peterkappelt/kHome/README.md

Devices for smart- and connected home.

Planned is (and there will surely be more in the future):
* a temperature sensor
* a thermostat
* a window contact
