peterkappelt/kHome/software/simple-quickfix/sensor_tempSensHW1_tirtos_ccs/README.md

## Example Summary

Sample application to control on-board LEDs with the PWM driver.

## Peripherals Exercised

* `Board_PWM0` - PWM instance used to control `Board_GPIO_LED0` brightness
* `Board_PWM1` - PWM instance used to control `Board_GPIO_LED1` brightness

## Resources & Jumper Settings

> If you're using an IDE (such as CCS or IAR), please refer to Board.html in your project
directory for resources used and board-specific jumper settings. Otherwise, you can find
Board.html in the directory &lt;SDK_INSTALL_DIR&gt;/source/ti/boards/&lt;BOARD&gt;.

## Example Usage

* Run the example.

* The onboard LEDs will slowly vary in intensity.

* If `Board_PWM0` and `Board_PWM1` are different (connected to two LEDs),
both LEDs will fade-in and fade-out when running the application.  Otherwise,
only one LED will fade-in and fade-out.

## Application Design Details

This application uses one thread, `mainThread` , which performs the following actions:

1. Opens and initializes PWM driver objects.

2. Uses the PWM driver to change the intensity of the LEDs.

3. The thread sleeps for 50 milliseconds before changing LED intensity again.

TI-RTOS:

* When building in Code Composer Studio, the kernel configuration project will be imported along with the example. The kernel configuration project is referenced by the example, so it will be built first. The "release" kernel configuration is the default project used. It has many debug features disabled. These feature include assert checking, logging and runtime stack checks. For a detailed difference between the "release" and "debug" kernel configurations and how to switch between them, please refer to the SimpleLink MCU SDK User's Guide. The "release" and "debug" kernel configuration projects can be found under &lt;SDK_INSTALL_DIR&gt;/kernel/tirtos/builds/&lt;BOARD&gt;/(release|debug)/(ccs|gcc).

FreeRTOS:

* Please view the `FreeRTOSConfig.h` header file for example configuration
information.
