peterkappelt/kHome/hardware/devices/temperatureSensor/software/CC1310/README.md

# temperatureSensor Hardware V1 Software

The embedded software is stored centrally.
You can find it at /software/cc1310
