peterkappelt/kHome/software/desktop/kHome-devedit/src/net/kappelt/kHome/devedit/kappelt-small-invers-135px.png

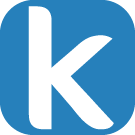
software/desktop/kHome-devedit/src/net/kappelt/kHome/devedit/kappelt-small-invers-135px.png
