peterkappelt/kHome/hardware/devices/temperatureSensor/temperatureSensor/Project Outputs for temperatureSensor/temperatureSensor_supplier.xls

Sheet: BOM Report
Bill of Materials |  |  | Bill of Materials For Variant [batch_one] of Project [temperatureSensor.PrjPcb] (No PCB Document Selected)
Source Data From: |  | temperatureSensor.PrjPcb
Project: |  | temperatureSensor.PrjPcb
Variant: |  | batch_one
Creation Date: | 18.03.2017 | 22:31:02
Print Date: | 2017-03-18 | 22:49:02
Production Quantity: | 5
Currency | <none>
Footprint | Comment | LibRef | Designator | Description | Quantity | Supplier 1 | Supplier Part Number 1 | Supplier Unit Price 1 | Supplier Order Qty 1 | Supplier Subtotal 1 | Manufacturer 1 | Manufacturer Part Number 1
Keystone-2468 | 2x AAA | Battery-AAA-Double | BT1 | Double AAA Battery Holder | 1 | Mouser | 534-2468 | 1,57 | 5 | 7,85 | Keystone Electronics | 2468
0603_N | 100n | 100n_50V_0603 | C1, C2, C4, C6, C8, C9, C10 | 100n 50V 0603 | 7 | Mouser | 710-885012206071 | 0,028 | 35 | 0,98 | Wurth Electronics | 885012206071
0805_N | 22u | 22u_25V_0805 | C3, C7 | 22u 25V 0805 | 2 | Mouser | 81-GRM21BC80G226ME9L | 0,09 | 10 | 0,9 | Murata Electronics | GRM21BC80G226ME39L
0603_N | 100p | 100p_50V_0603 | C11 | 100p 50V 0603 | 1 | Mouser | 710-885012206003 | 0,038 | 5 | 0,19 | Wurth Electronics | 885012206003
0603_N | 3.3p | 3p3_50V_0603 | C12, C21 | 3p3 50V 0603 | 2 | Mouser | 81-GRM1885C1H3R3CA1D | 0,026 | 10 | 0,26 | Murata Electronics | GRM1885C1H3R3CA01D
0805_N | 15p | 10p_50V_0805 | C15, C16 | 15p 50V 0805 | 2 | Mouser | 710-885012007001 | 0,066 | 10 | 0,66 | Wurth Electronics | 885012007001
0603_N | 1p | 100p_50V_0603 | C17 | 1p 50V 0603 | 1 | Mouser | 609-251R14S1R0CV4T | 0,085 | 5 | 0,425 | Johanson Dielectrics | 251R14S1R0CV4T
0603_N | 2.7p | 3p3_50V_0603 | C18 | 2p7 50V 0603 | 1 | Mouser | 81-GRM1885C1H2R7CA1D | 0,027 | 10 | 0,27 | Murata Electronics | GRM1885C1H2R7CA01D
0603_N | 6.2p | 3p3_50V_0603 | C19 | 6p2 50V 0603 | 1 | Mouser | 581-06032U6R2BAT2A | 0,094 | 5 | 0,47 | AVX | 06032U6R2BAT2A
0603_N | 3.0p | 3p3_50V_0603 | C20 | 3p 50V 0603 | 1 | Mouser | 581-06035U3R0B | 0,094 | 5 | 0,47 | AVX | 06035U3R0BAT2A
0603_N | 1u | 1u_50V_0603 | C22 | 1u 50V 0603 | 1 | Mouser | 710-885012106010 | 0,075 | 5 | 0,375 | Wurth Electronics | 885012106010
cortex-dbg | Cortex Debug | Cortex-DBG | CON1 | Cortex Debug | 1
Header_254_1x3_male | 1x3 | Header_1x03_male | CON2 | Male Connector 1x3 | 1
0805_LED | LED Red | LED-STD-RED-0805 | D1 | Standard LED Red 0805 | 1 | Mouser | 604-AP2012EC | 0,123 | 5 | 0,615 | Kingbright | AP2012EC
0603_N | Ferrite Bead | Inductor_General_Purpose_0603 | L1 | Ferrite Bead | 1 | Mouser | 81-BLM18HE152SN1D | 0,198 | 5 | 0,99 | Murata Electronics | BLM18HE152SN1D
0805_N | 6.8 µH | Inductor_General_Purpose_0603 | L2 | Chip Inductor 0805 | 1 | Mouser | 810-MLZ2012N6R8L | 0,123 | 5 | 0,615 | TDK | MLZ2012N6R8L
0603_N | 8.2nH | Inductor_General_Purpose_0603 | L3, L7 | 8.2nH Inductor | 2 | Mouser | 81-LQG15HS8N2J02D | 0,046 | 10 | 0,46 | Murata Electronics | LQG15HS8N2J02D
0603_N | 22nH | Inductor_General_Purpose_0603 | L4 | 22nH Inductor | 1 | Mouser | 81-LQG15HS22NJ02D | 0,046 | 10 | 0,46 | Murata Electronics | LQG15HS22NJ02D
0603_N | 6.8nH | Inductor_General_Purpose_0603 | L5, L6 | 6.8H Inductor | 2 | Mouser | 81-LQG15HS6N8J02D | 0,046 | 10 | 0,46 | Murata Electronics | LQG15HS6N8J02D
0603_N | 12nH | Inductor_General_Purpose_0603 | L8 | Inductor for PCB Antenna compensation | 1 | Mouser | 609-L-14C12NJV4T | 0,066 | 5 | 0,33 | Johanson Technology | L-14C12NJV4T
LFXTAL058124 | Quartz 20 MHz | LFXTAL058124 | Q2 | Standard 3.2 x 2.5mm SMD crystal in a ceramic package with a seam sealed metal lid, hermetically sealed. | 1 | Mouser | 449-LFXTAL058124REEL | 0,462 | 5 | 2,31 | IQD | LFXTAL058124Reel
0603_N | 0R | 0R_100mW_0603 | R2 | 0R 100mW 0603 | 1
0805_N | 10k | 10k_125mW_0805 | R5, R6 | 10k 125mW 0805 | 2 | Mouser | 588-AS08J1002ET | 0,045 | 10 | 0,45 | Ohmite | AS08J1002ET
0603_N | 100k | 100k_100mW_0603 | R7 | 100k 100mW 0603 | 1 | Mouser | 71-RCA0603100KJNEC | 0,085 | 5 | 0,425 | Vishay / Draloric | RCA0603100KJNEC
0603_N | 1k | 1k_100mW_0603 | R8 | 1k 100mW 0603 | 1 | Mouser | 71-CRCW0603-1.0K-E3 | 0,041 | 10 | 0,41 | Vishay | CRCW06031K00FKEA
FSMSM | Push Button | Switch-FSMSM | SW1 | Taster, Nicht beleuchtet, 24 V, 50 mA, 180 gf, Baureihe FSMSM, AlcoSwitch | 1 | Mouser | 506-FSMSM | 0,255 | 5 | $1275.00 | TE Connectivity / Alcoswitch | FSMSM
SI7020-DFN6 | Humidity & Temperature | SI7020 | U1 | I2C HUMIDITY AND TEMPERATURE SENSOR | 1 | Mouser | 634-SI7020-A20-GMR | 2,93 | 5 | 14,65 | Silicon Labs | SI7020-A20-GMR
CC1310F128RHB-QFN32 | CC1310 | CC1310F128RHB | U3 | CC1310 SimpleLink™ Ultra-Low-Power Sub-1 GHz Wireless MCU | 1 | Mouser | 595-CC1310F32RHBT | 5,65 | 5 | 28,25 | Texas Instruments | CC1310F32RHBT
 |  |  |  |  | 40 |  |  |  |  | $1275.00
Approved |  | Notes

Sheet: Project Information
Project Full Path | C:\Users\peter\Documents\Projekte\kHome\hardware\devices\temperatureSensor\temperatureSensor\temperatureSensor.PrjPcb
Project Filename | temperatureSensor.PrjPcb
Variant Name | batch_one
Data-Source Filename | temperatureSensor.PrjPcb
Data-Source Full Path | C:\Users\peter\Documents\Projekte\kHome\hardware\devices\temperatureSensor\temperatureSensor\temperatureSensor.PrjPcb
Title | Bill of Materials For Variant [batch_one] of Project [temperatureSensor.PrjPcb] (No PCB Document Selected)
Total Quantity | 40
Report Time | 22:31:02
Report Date | 18.03.2017
Report Date & Tine | 18.03.2017 22:31:02
Output Name | Bill of Materials
Output Type | BOM_PartType
Output Generator Name | BOM
Output Generator Description | Bill of Materials
