peterkappelt/kHome/doc/hardware/cc1310/cc1310emk/swrc315_design_files/assembly/CC13xxEM-5XD-7793_4L_partlist_1_0_0.xls

CC13xxEM-5XD-7793_4L Revised: Monday, October 19, 2015
Revision: 1.0.0
Bill Of Materials October 19,2015 20:55:34 | Page1
Part number | Quantity | Reference | Value | Description | Manufacturer | Manufacturer part number | PCB Package | Max operating temp | Note status | RoHS status
______________________________________________
13-00397 | 1 | A1 | Antenna PCB helix 868/915MHz | ANTENNA, NON COMPONENT, PCB HELIX 868/915MHz, NOT APPLY | TEXAS INSTRUMENTS | ANTENNA PCB HELIX 868/915MHz |  | N/A | PREFERRED | ROHS_COMPLIANT
02-02323 | 6 | C3,C4,C6,C9,C20,C23 | 100nF | CAPACITOR, CERAMIC X7R, 100nF, 6.3V, -10%/+10%, -55DEGC/+125DEGC, 0402, SMD | MURATA | GRM155R70J104KA01D | 402 | +125DEGC | PREFERRED | ROHS_COMPLIANT
02-07053 | 2 | C5,C8 | 22uF | CAPACITOR, CERAMIC, X5R, 22uF, 6.3V, -20%/+20%, -55DEGC/+85DEGC, 0603, SMD | MURATA | GRM188R60J226MEA0D | 603 | +85DEGC | PREFERRED | ROHS_COMPLIANT
02-04369 | 2 | C11,C22 | 3.3pF | CAPACITOR, CERAMIC C0G/NP0, 3.3pF, 50V, -0.25pF/+0.25pF, -55DEGC/+125DEGC, 0402, SMD | MURATA | GRM1555C1H3R3CA01D | 402 | +125DEGC | PREFERRED | ROHS_COMPLIANT
02-04679 | 1 | C12 | 2.7pF | CAPACITOR, CERAMIC C0G/NP0, 2.7pF, 50V, -0.25pF/+0.25pF, -55DEGC/+125DEGC, 0402, SMD | MURATA | GRM1555C1H2R7CA01D | 402 | +125DEGC | PREFERRED | ROHS_COMPLIANT
02-04608 | 1 | C13 | 6.2pF | CAPACITOR, CERAMIC C0G/NP0, 6.2pF, 50V, -0.25pF/+0.25pF, -55DEGC/+125DEGC, 0402, SMD | MURATA | GRM1555C1H6R2CA01D | 402 | +125DEGC | PREFERRED | ROHS_COMPLIANT
02-04606 | 1 | C14 | 3pF | CAPACITOR, CERAMIC C0G/NP0, 3pF, 50V, -0.25pF/+0.25pF, -55DEGC/+125DEGC, 0402, SMD | MURATA | GRM1555C1H3R0CA01D | 402 | +125DEGC | PREFERRED | ROHS_COMPLIANT
02-04365 | 2 | C15,C21 | 100pF | CAPACITOR, CERAMIC C0G/NP0, 100pF, 50V, -5%/+5%, -55DEGC/+125DEGC, 0402, SMD | MURATA | GRM1555C1H101JA01D | 402 | +125DEGC | PREFERRED | ROHS_COMPLIANT
02-04164 | 1 | C16 | DNM_0402 | CAPACITOR, CERAMIC, N/A VALUE, -55DEGC/+125DEGC, 0402, SMD | MANUFACTURER SELECTION | CAPACITOR_0402_DNM_N/A_M | 402 | +125DEGC | PREFERRED | MISSING_INFO
02-03030 | 2 | C17,C18 | 12pF | CAPACITOR, CERAMIC C0G/NP0, 12pF, 50V, -5%/+5%, -55DEGC/+125DEGC, 0402, SMD | MANUFACTURER SELECTION | CAPACITOR_0402_12pF_C0G/NP0_M_+/-5%_50V | 402 | +125DEGC | PREFERRED | ROHS_COMPLIANT
02-02381 | 1 | C19 | 1uF | CAPACITOR, CERAMIC X5R, 1uF, 10V, -10%/+10%, -55DEGC/+85DEGC, 0402, SMD | MURATA | GRM155R61A105KE15D | 402 | +85DEGC | PREFERRED | ROHS_COMPLIANT
02-04164 | 2 | C24,C25 | DNM | CAPACITOR, CERAMIC, N/A VALUE, -55DEGC/+125DEGC, 0402, SMD | Manufacturer selection | CAPACITOR_0402_DNM_N/A_M | 402 | +125DEGC | PREFERRED | PART NOT KNOWN
19-00111 | 6 | FIDU1,FIDU2,FIDU3,FIDU4,FIDU5,FIDU6 | FIDU_1MM | FIDUCIAL MARK, ROUND 1MM
04-00470 | 1 | FL1 | BLM18HE152SN1 | FILTER, EMI, 1500@100MHz, -55DEGC/+125DEGC, 0603, SMD | MURATA | BLM18HE152SN1D | 603 | +125DEGC | PREFERRED | ROHS_COMPLIANT
06-02188 | 1 | J1 | SMA-10V21-TGG | CONNECTOR, COAX RF, STRAIGHT, FEMALE, 1 PIN, SMD | HUS-TSAN | SMA-10V21-TGG |  |  | PREFERRED | N/A
03-07266 | 1 | L1 | 6.8uH | INDUCTOR, CHIP, FERRITE CORE, 6.8uH, -20%/+20%, IR:1.1A, -55DEGC/+125DEGC, 0805, SMD | TDK | MLZ2012N6R8LT000 | 805 | +125DEGC | PREFERRED | ROHS_COMPLIANT
03-06537 | 1 | L11 | 22nH | INDUCTOR, RF, CHIP, NON-MAGNETIC CORE, 22nH, -5%/+5%, 0.3A, -55DEGC/+125DEGC, 0402, SMD | MURATA | LQG15HS22NJ02D | 402 | +125DEGC | PREFERRED | ROHS_COMPLIANT
03-06634 | 2 | L12,L21 | 8.2nH | INDUCTOR, RF, CHIP, NON-MAGNETIC CORE, 8.2nH, -5%/+5%, 0.3A, -55DEGC/+125DEGC, 0402, SMD | MURATA | LQG15HS8N2J02D | 402 | +125DEGC | PREFERRED | ROHS_COMPLIANT
03-06633 | 2 | L13,L14 | 6.8nH | INDUCTOR, CHIP, 6.8nH, -5%/+5%, 0.3A, -55DEGC/+125DEGC, 0402, SMD | MURATA | LQG15HS6N8J02D | 402 | +125DEGC | PREFERRED | ROHS_COMPLIANT
03-01022 | 1 | L15 | TBD | INDUCTOR, TO BE DECIDED, 0402, SMD | MANUFACTURER SELECTION | IND_TBD_0402 |  |  | PREFERRED | ROHS_COMPLIANT
06-02251 | 2 | P1,P2 | SFM-110-02-S-D-A-K-TR | CONNECTOR, HEADER, FEMALE, STRAIGHT, 2 ROWS, 20 PINS, PITCH 1.27mm, SMD | SAMTEC | SFM-110-02-SM-D-A-K-TR |  | +125DEGC | PREFERRED | ROHS_COMPLIANT
01-12837 | 1 | R1 | 100k | RESISTOR, THICK FILM, 100k, -1%/+1%, 0.063W, 50V, -55DEGC/+155DEGC, 0402, SMD | MANUFACTURER SELECTION | RESISTOR_0402_100k_+/-1%_50V_0.063W_M_+/-100PPM | 402 | +155DEGC | PREFERRED | ROHS_COMPLIANT
01-11587 | 3 | R2,R5,R6 | 0 | RESISTOR, THICK FILM, 0, -5%/+5%, 0.063W, 50V, -55DEGC/+155DEGC, 0402, SMD | MANUFACTURER SELECTION | RESISTOR_0402_0_+/-5%_50V_0.063W_M_+/-200ppm | 402 | +155DEGC | PREFERRED | ROHS_COMPLIANT
01-02472 | 2 | R3,R4 | DNM | RESISTOR, DO NOT MOUNT, 0402, SMD | DO NOT MOUNT | DNM | 402 | N/A | PREFERRED | PART NOT KNOWN
18-28965 | 1 | U1 | CC13xx 5x5 | IC, ANALOG, CUSTOM, CC13xx 5x5, QFN32, SMD | TEXAS INSTRUMENTS | CC13XX 5X5 | QFN32 | N/A | PREFERRED | PART NOT KNOWN
12-00546 | 1 | Y1 | 32.768kHz | CRYSTAL, RESONATOR, 32.768kHz, -20PPM/+20PPM, -40DEGC/+85DEGC, SMD | EPSON | FC-135 32.7680KA-AG0 |  | +85DEGC | PREFERRED | ROHS_COMPLIANT
12-00419 | 1 | Y2 | 24MHz | CRYSTAL, OSCILATOR, 24MHz, -40DEGC/+85DEGC, SMD | EPSON | TSX-3225 24MHz |  | +85DEGC | PREFERRED | ROHS_COMPLIANT
