peterkappelt/kHome/(list of files, cad)

Other CAD files:
software/simple-quickfix/tirtos_builds_tempSens_HW1_release_ccs/src/sysbios/m3_IntrinsicsSupport_asm.obj
software/simple-quickfix/tirtos_builds_tempSens_HW1_release_ccs/src/sysbios/m3_TaskSupport_asm.obj
software/simple-quickfix/tirtos_builds_tempSens_HW1_release_ccs/src/sysbios/m3_Hwi_asm.obj
software/simple-quickfix/tirtos_builds_tempSens_HW1_release_ccs/src/sysbios/m3_Hwi_asm_switch.obj
software/simple-quickfix/tirtos_builds_tempSens_HW1_release_ccs/src/sysbios/rom_sysbios.obj
software/cc1310/tirtos_builds_tempSens_HW1_release_ccs/src/sysbios/m3_Hwi_asm_switch.obj
software/cc1310/tirtos_builds_CC1310_LAUNCHXL_release_ccs/src/sysbios/m3_Hwi_asm.obj
software/cc1310/tirtos_builds_tempSens_HW1_release_ccs/src/sysbios/m3_IntrinsicsSupport_asm.obj
software/cc1310/tirtos_builds_CC1310_LAUNCHXL_release_ccs/src/sysbios/m3_IntrinsicsSupport_asm.obj
software/cc1310/tirtos_builds_tempSens_HW1_release_ccs/src/sysbios/m3_Hwi_asm.obj
software/cc1310/tirtos_builds_CC1310_LAUNCHXL_release_ccs/src/sysbios/m3_TaskSupport_asm.obj
software/cc1310/tirtos_builds_tempSens_HW1_release_ccs/src/sysbios/m3_TaskSupport_asm.obj
software/cc1310/tirtos_builds_CC1310_LAUNCHXL_release_ccs/src/sysbios/m3_Hwi_asm_switch.obj
software/cc1310/tirtos_builds_CC1310_LAUNCHXL_release_ccs/src/sysbios/rom_sysbios.obj
software/cc1310/tirtos_builds_tempSens_HW1_release_ccs/src/sysbios/rom_sysbios.obj
