peterkappelt/kHome/software/cc1310/kHome-Gateway/kHome/test-device.html

# Device Report: test.khd

## Meta Information

- Author: Peter Kappelt
- Device ID: 0xAB
- Device Version: V1.0
- Device Comment: This is an empty device. Just for testing! An a second line of description.

## Data Registers

Address | Name | Length (Byte) | Initial Value | Read Only | Description
0x1 | dataRegOne | 2 | 15 | true | Read only, initial 15, dataRegOne, Length 2, Address 1
0x2 | dataRegTwo | 4 | 2 | false | initial 2, dataRegTwo, Length 4, Address 2

## Config Registers

Address | Name | Initial Value | Read Only | Description
0x5 | configOne | 2 | false | configOne, address 5, value 2
0x6 | configTwo | 7 | true | configTwo: address 6 value 7 read only

## Status Registers

Address | Name | Initial Value | Description
0x8 | statusOne | 3 | statusOne: Value 3 Address 8
0x9 | statusTwo | 200 | statusTwo: address 9 value 200
