peterkappelt/kHome/doc/hardware/cc1310/launchpad/design_files/LAUNCHXL-CC1310_1_3_0_Assy.pdf

## ART FILM - assembly_top

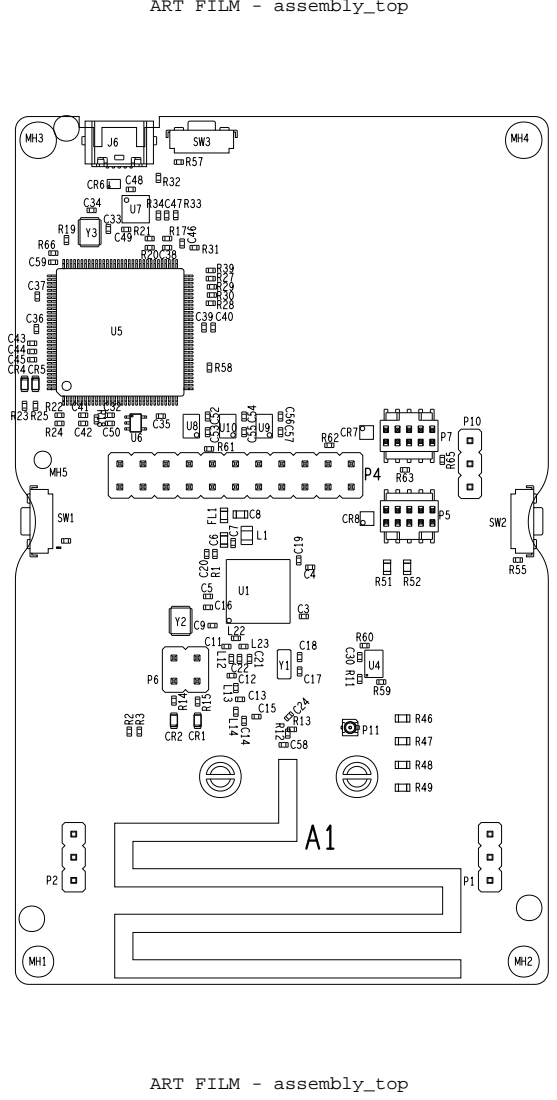
[picture p15: page 1]

## ART FILM - assembly_bottom_mirrored

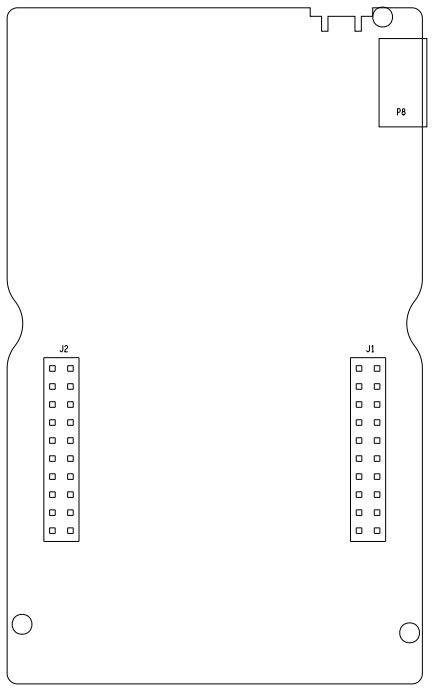
[picture p16: figure]

## ART FILM - assembly_bottom_mirrored
