peterkappelt/kHome/doc/hardware/cc1310/cc1310emk/swrc315_design_files/docs/CC13xxEM_5XD_7793_4L_assembly_1_0_0.pdf

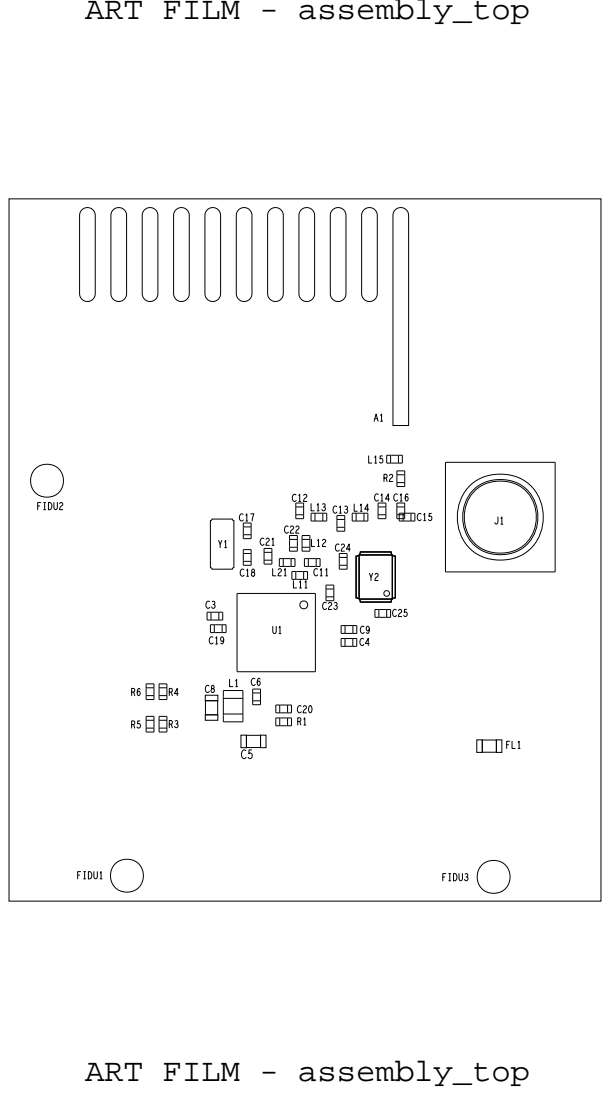
[picture p17: page 1]

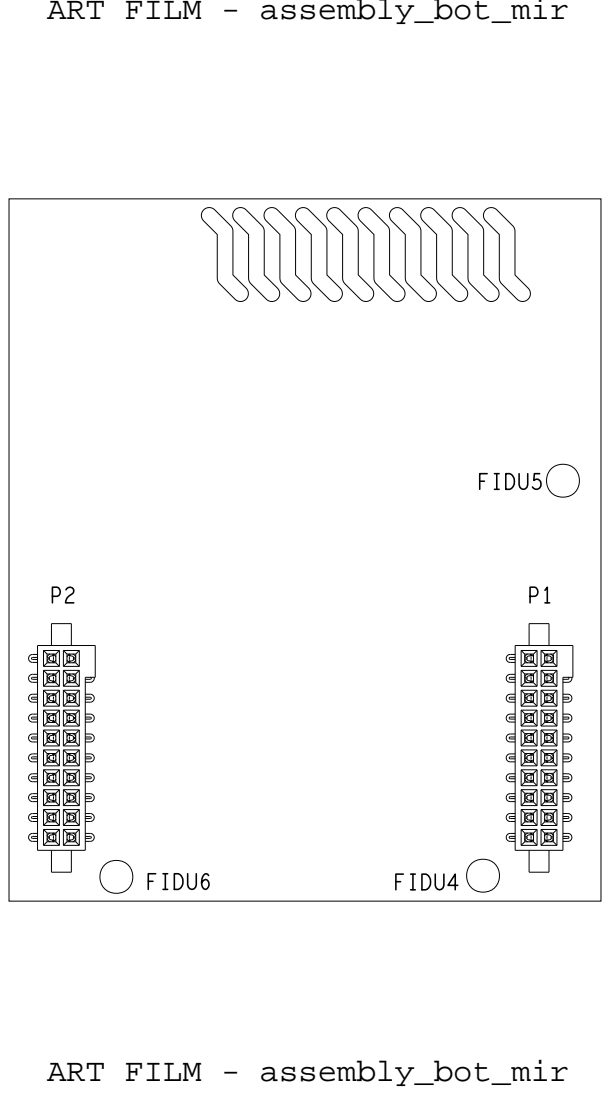
[picture p18: page 2]
ART FILM - assembly_bot_mir; FIDU6; FIDU4; FIDU5

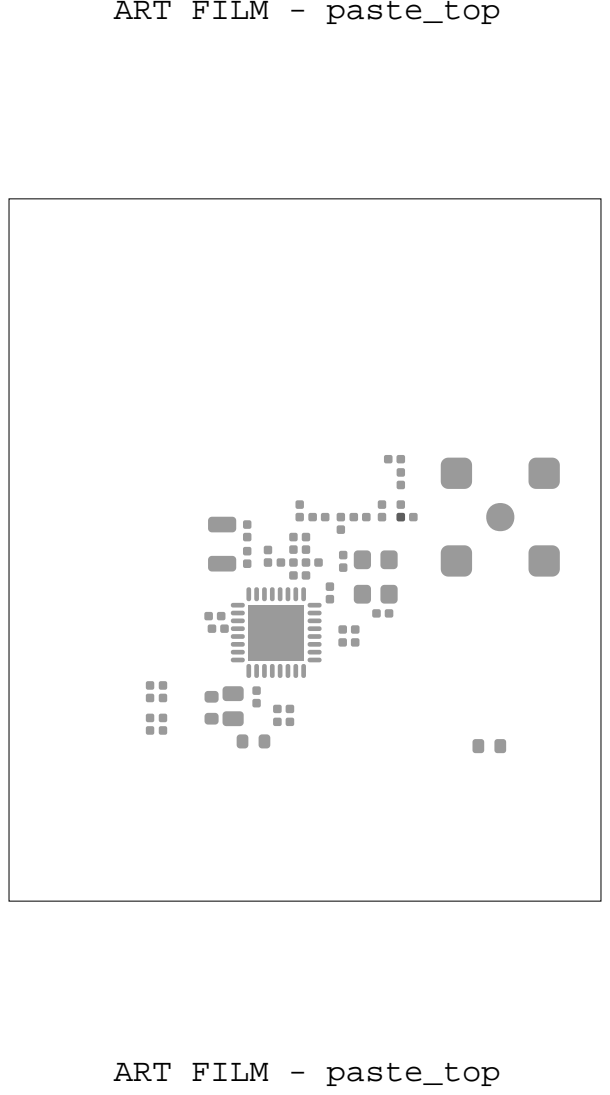
[picture p19: page 3]
ART FILM - paste_top

ART FILM - paste_bottom

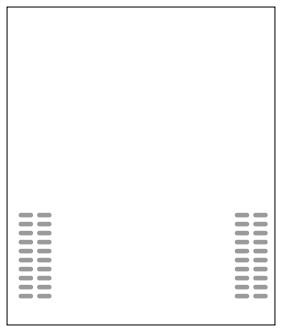
[picture p20: figure]

ART FILM - paste_bottom
