peterkappelt/kHome/doc/hardware/cc1310/cc1310emk/swrc315_design_files/docs/CC13xxEM_5XD_7793_4L_mech_draw_1_0.pdf

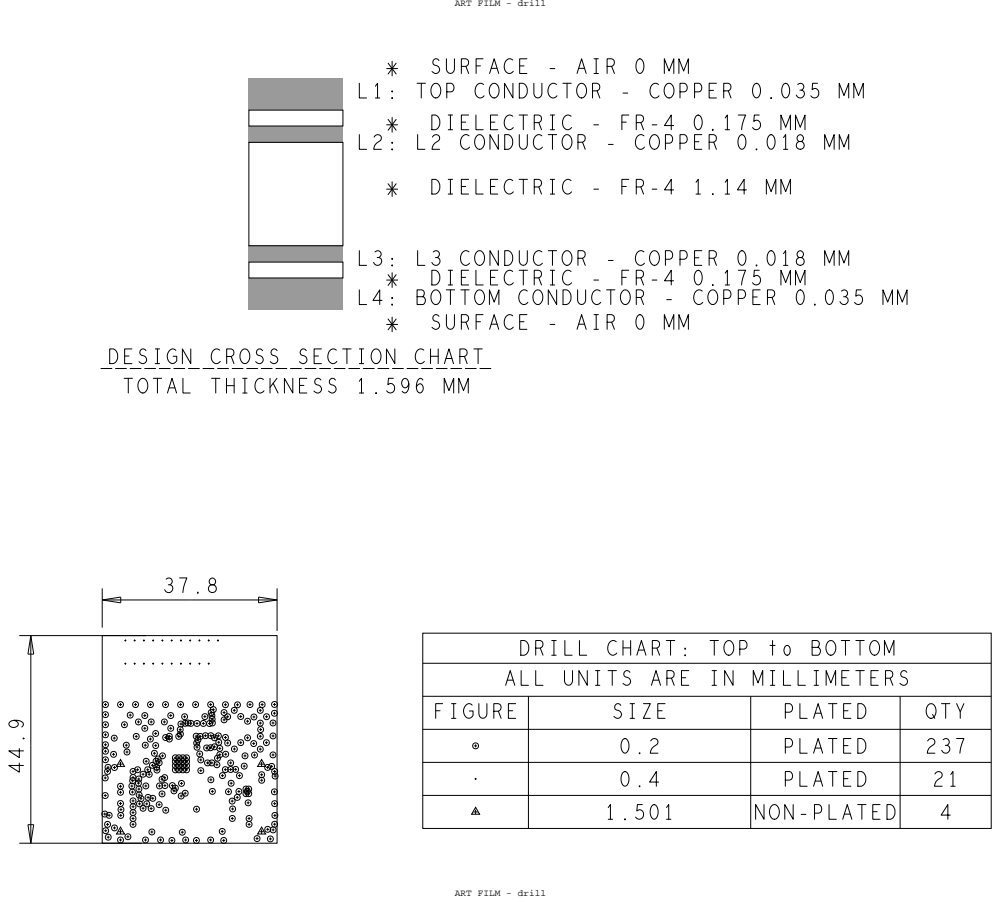
[picture p21: page 1]
QTY 237 21 4; PLATED PLATED PLATED NON-PLATED; SIZE 0.2 0.4 1.501

ART FILM - drill

* SURFACE - AIR 0 MM
L1: TOP CONDUCTOR - COPPER 0.035 MM
* DIELECTRIC - FR-4 0.175 MM
L2: L2 CONDUCTOR - COPPER 0.018 MM
* DIELECTRIC - FR-4 1.14 MM

L3: L3 CONDUCTOR - COPPER 0.018 MM
L4: BOTTOM CONDUCTOR - COPPER 0.035 MM

DESIGN CROSS SECTION CHART
TOTAL THICKNESS 1.596 MM

DRILL CHART: TOP to BOTTOM
ALL UNITS ARE IN MILLIMETERS
FIGURE
