peterkappelt/kHome/doc/hardware/cc1310/launchpad/design_files/PCB/LAUNCHXL-CC1310_1_3_0_Mech.pdf

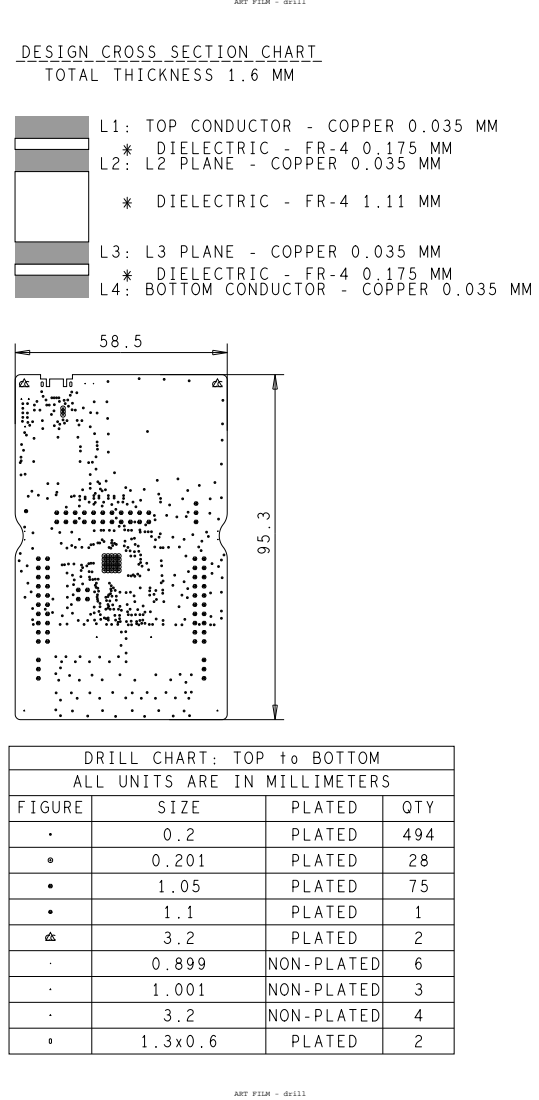
[picture p22: page 1]
QTY; PLATED; NON-PLATED; SIZE; ALL UNITS ARE IN MILLIMETERS; DRILL CHART: TOP to BOTTOM; FIGURE

ART FILM - drill

___________________________ DESIGN CROSS SECTION CHART
TOTAL THICKNESS 1.6 MM
L1: TOP CONDUCTOR - COPPER 0.035 MM
* DIELECTRIC - FR-4 0.175 MM
L2: L2 PLANE - COPPER 0.035 MM
* DIELECTRIC - FR-4 1.11 MM
L3: L3 PLANE - COPPER 0.035 MM
L4: BOTTOM CONDUCTOR - COPPER 0.035 MM
