peterkappelt/kHome/doc/hardware/cc1310/cc1310emk/swrc315_design_files/docs/CC13xxEM_5XD_7793_4L_layout_1_0.pdf

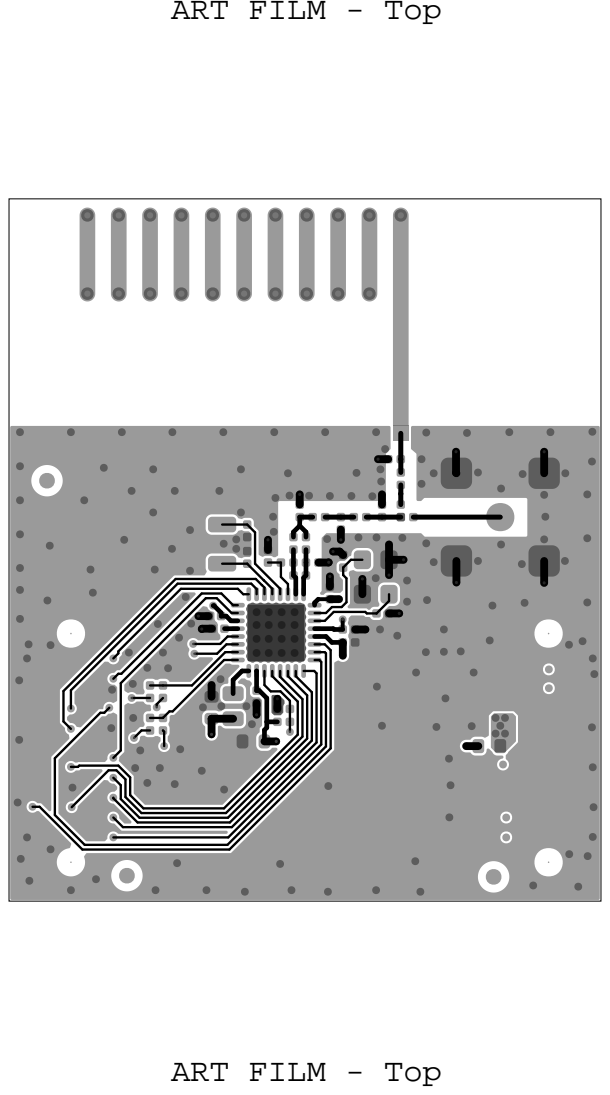
[picture p23: page 1]

ART FILM - Top

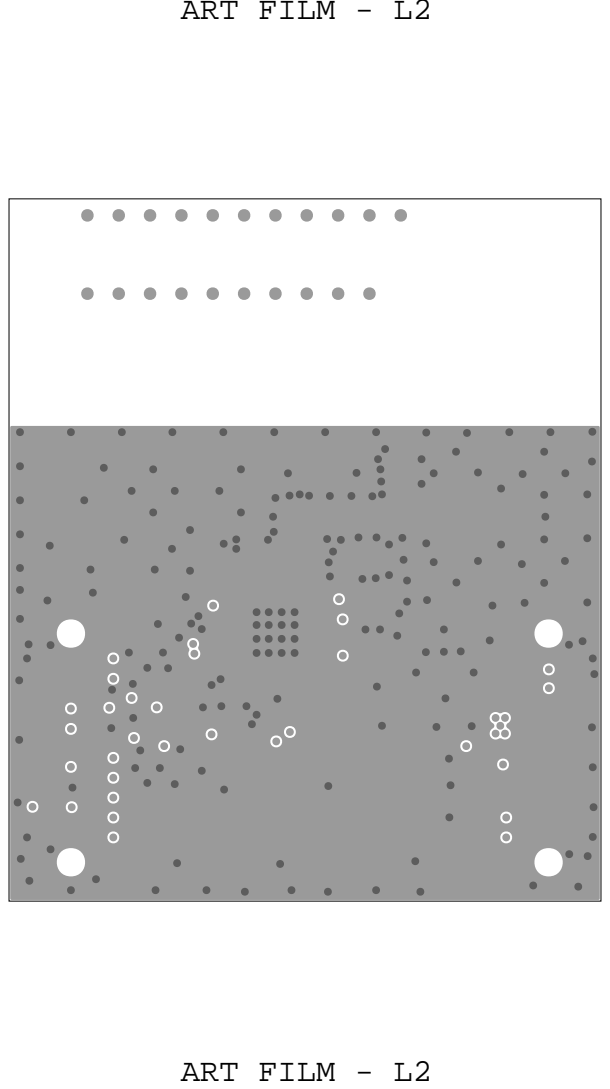
[picture p24: page 2]
ART FILM - L2

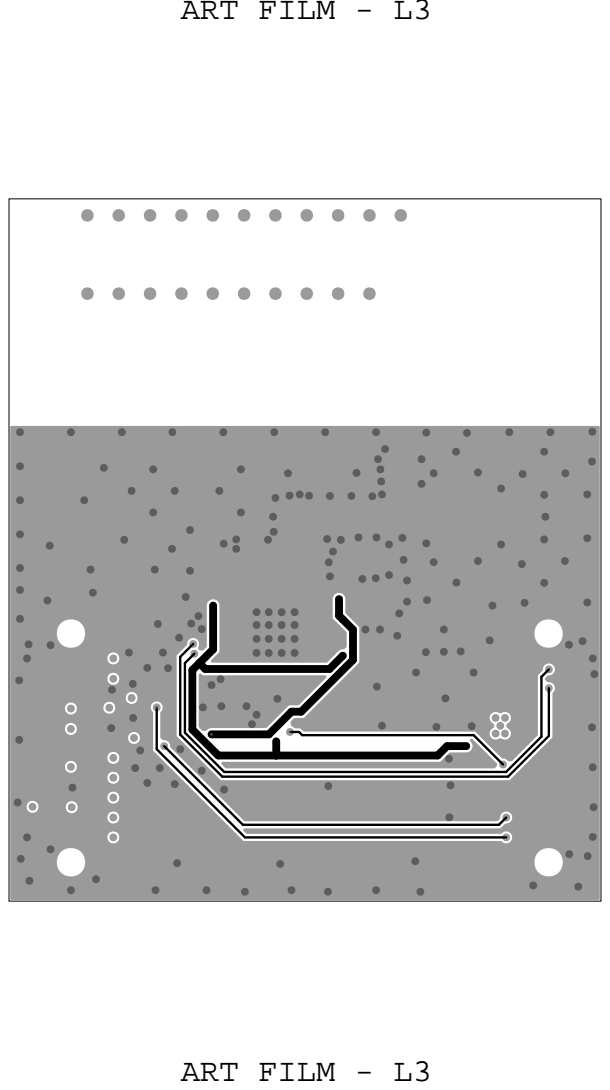
[picture p25: page 3]
ART FILM - L3

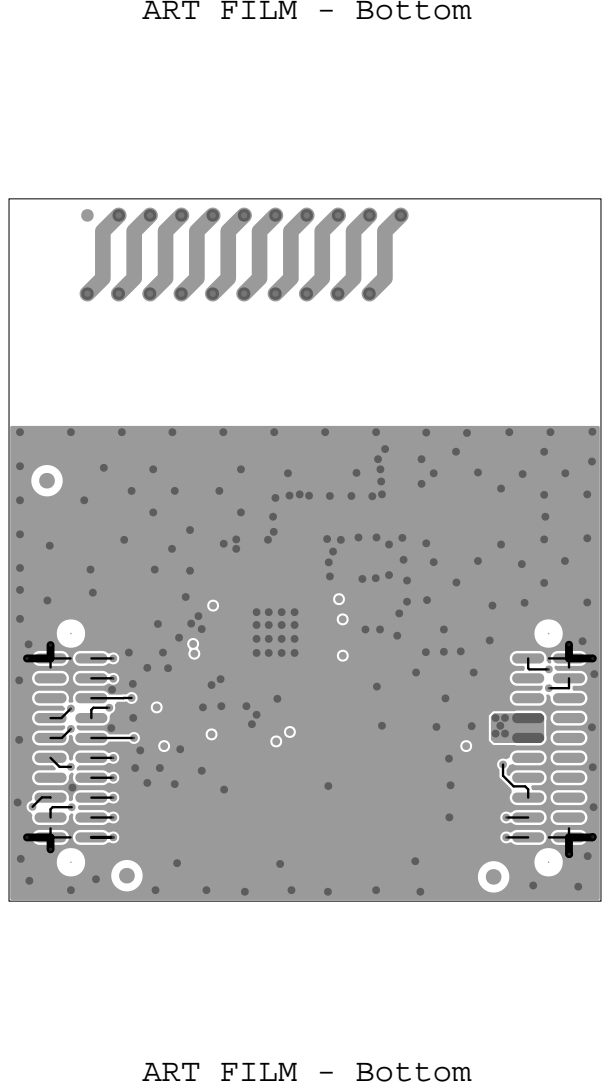
[picture p26: page 4]

ART FILM - Bottom

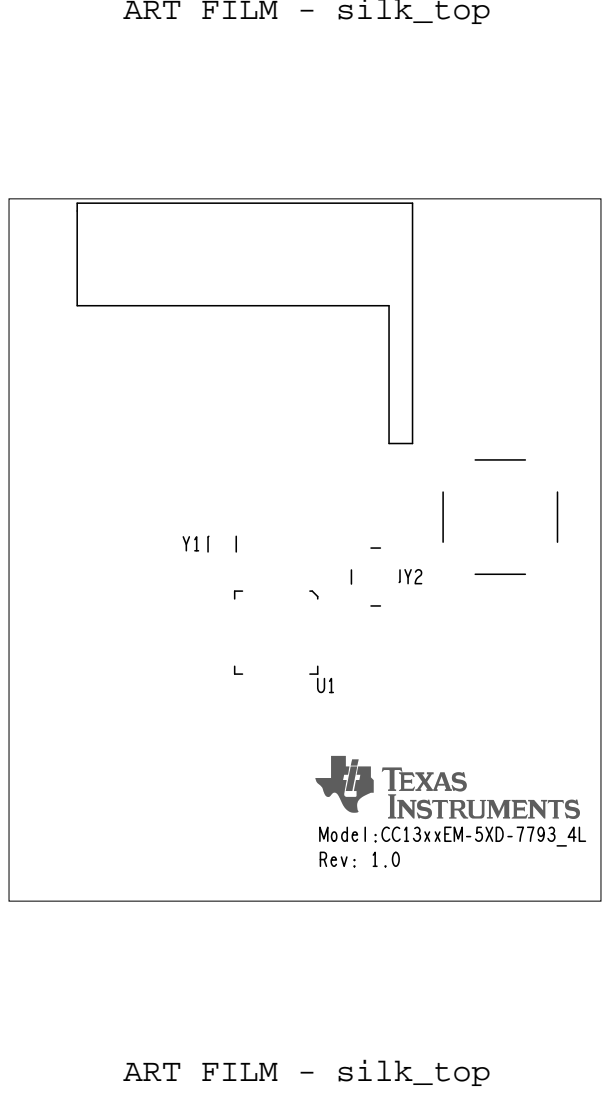
[picture p27: page 5]
ART FILM - silk_top; Rev: 1.0; Model:CC13xxEM-5XD-7793_4L

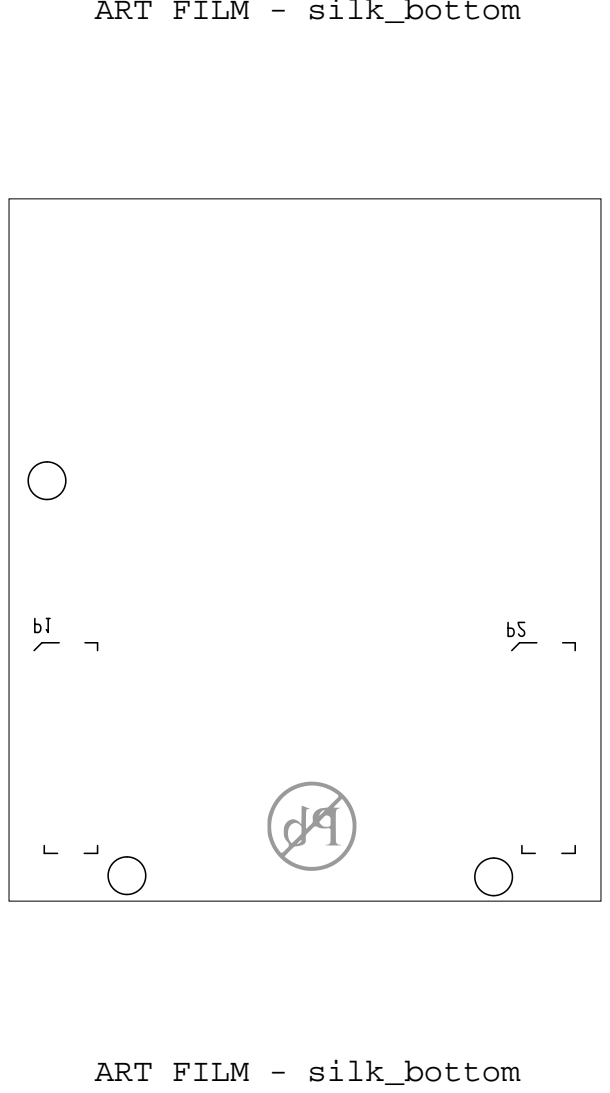
[picture p28: page 6]
ART FILM - silk_bottom

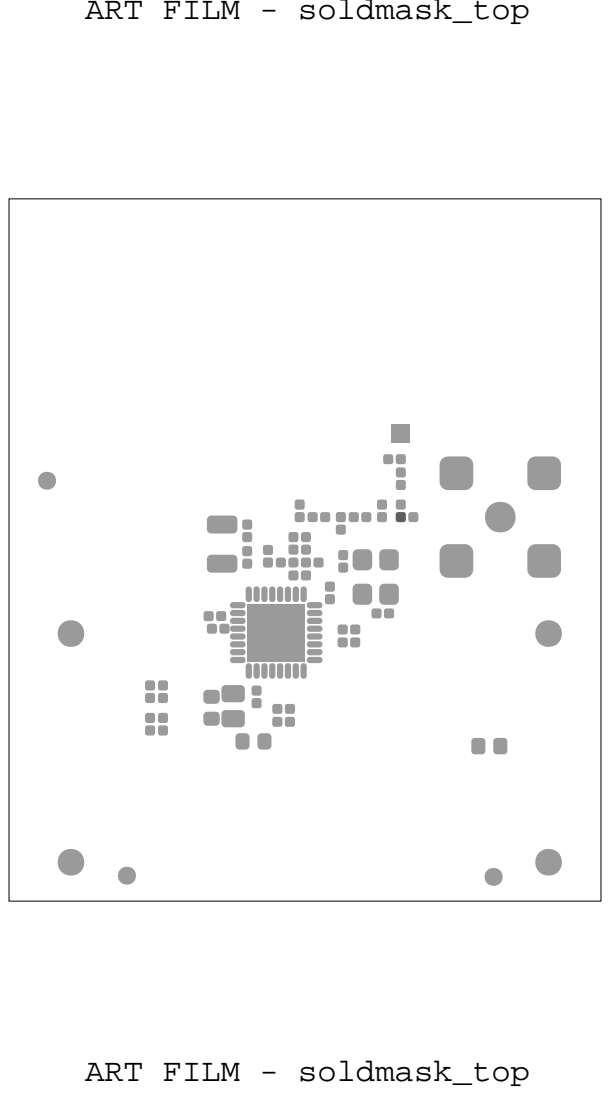
[picture p29: page 7]
ART FILM - soldmask_top

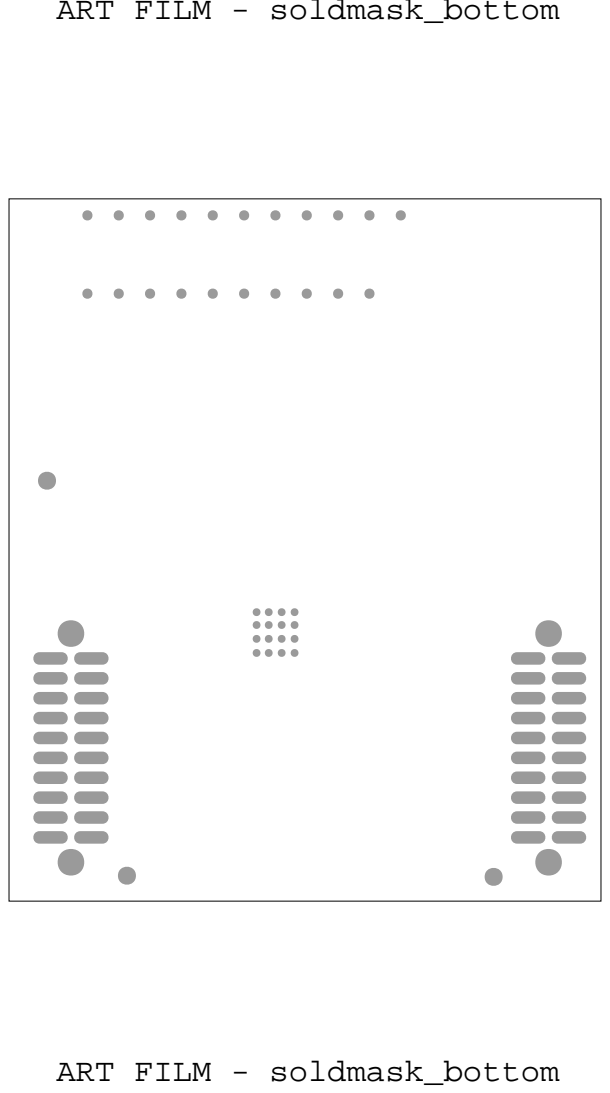
[picture p30: page 8]
ART FILM - soldmask_bottom
