peterkappelt/kHome/(list of files, drawings)

Other design files:
doc/hardware/cc1310/cc1310emk/swrc315_design_files/Cadence/CC13xxEM_5XD_7793_4L.DSN
doc/hardware/cc1310/launchpad/design_files/Cadence/LAUNCHXL-CC1310.DSN
doc/hardware/cc1310/launchpad/design_files/Cadence/launchxl-cc1310.opj
hardware/devices/temperatureSensor/temperatureSensor/PCB/temperatureSensor.PcbDoc
hardware/devices/temperatureSensor/temperatureSensor/SCH/temperatureSensor.SchDoc
hardware/devices/temperatureSensor/temperatureSensor/temperatureSensor.PrjPcb
