peterkappelt/kHome/software/desktop/kHome-gateway-mqtt/src/mqtt.h

/**
 * @file mqtt.h
 * @author Peter Kappelt
 */

#include <stdint.h>

void mqttOpen(void);
void mqttClose(void);
void mqttPublishDataRegister(uint8_t deviceAddress, uint8_t registerAddress, uint32_t value);
void mqttPublishConfigRegister(uint8_t deviceAddress, uint8_t registerAddress, uint8_t value);
void mqttPublishStatusRegister(uint8_t deviceAddress, uint8_t registerAddress, uint8_t value);
