peterkappelt/kHome/software/simple-quickfix/sensor_tempSensHW1_tirtos_ccs/programmingMode/programmingMode.h

/**
 * @file programmingMode.h
 * @author Peter Kappelt
 * @date 29.4.2017
 */

#ifndef PROGRAMMINGMODE_PROGRAMMINGMODE_H_
#define PROGRAMMINGMODE_PROGRAMMINGMODE_H_


void programmingModeSetLed(uint8_t state);
void programmingModeInit(void);


#endif /* PROGRAMMINGMODE_PROGRAMMINGMODE_H_ */
