peterkappelt/kHome/(commit log)

2017-02-25 kHome: Preperations, temperatureSensor hardware first steps
    [LAUNCHXL-CC1310.DSN, LAUNCHXL-CC1310.brd, LAUNCHXL-CC1310_1_3_0_BOM.xlsx, art_param.txt, cases.cfg, launchxl-cc1310.opj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]
2017-02-26 kHome: design files of the CC130 development kit
    [CC13xxEM-5XD-7793_4L_partlist_1_0_0.xls, CC13xxEM_5XD_7793_4L.DSN, CC13xxEM_5XD_7793_4L.brd, art_param.txt, nc_param.txt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]
2017-02-26 kHome temperatureSensor: library components, first schematic steps
    [temperatureSensor.PrjPcb, temperatureSensor.SchDoc]
2017-03-03 kHome: (almost) finished schematic of temperatureSensor (Antenna solution is still missing)
    [CC13xxEM-5XD-7793_4L_partlist_1_0_0.xls, temperatureSensor.PcbDoc, temperatureSensor.PrjPcb, temperatureSensor.SchDoc]
2017-03-04 kHome: PCB Antenna, Board Layout
    [temperatureSensor.PcbDoc, temperatureSensor.PrjPcb, temperatureSensor.SchDoc]
2017-03-05 kHome: PCB Logo
    [temperatureSensor.PcbDoc]
2017-03-05 kHome: temperatureSensor output files (gerber, drill)
    [temperatureSensor.GBL, temperatureSensor.GBO, temperatureSensor.GBP, temperatureSensor.GBS, temperatureSensor.GKO, temperatureSensor.GM1, temperatureSensor.GTL, temperatureSensor.GTO]
2017-03-08 kHome: Antenna matching, BOM for order
    [temperatureSensor.PcbDoc, temperatureSensor.PrjPcb, temperatureSensor.SchDoc, temperatureSensor_supplier.xls]
2017-03-11 kHome: specification V0.2 (device files, Devedit-Tools)
2017-03-13 kHome Devedit: Possibility to open a Device File with the program call
2017-03-23 Bill of Materials for Parts Order of temperatureSensor
    [temperatureSensor.PrjPcb, temperatureSensor_supplier.xls]
2017-03-25 Improved folder structure
    [CC13xxEM-5XD-7793_4L_partlist_1_0_0.xls, CC13xxEM_5XD_7793_4L.DSN, CC13xxEM_5XD_7793_4L.brd, LAUNCHXL-CC1310.DSN, LAUNCHXL-CC1310.brd, LAUNCHXL-CC1310_1_3_0_BOM.xlsx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]
2017-04-02 current development version of the CC1310 embedded software (telegram parsing and handling, register editing) Not fully functional and bug-free!
    [m3_Hwi_asm.obj, m3_Hwi_asm_switch.obj, m3_IntrinsicsSupport_asm.obj, m3_TaskSupport_asm.obj, release.cfg, rom_sysbios.obj]
2017-04-05 Embedded Software: Handling of own address, khRF receive/ transmit mode switching Caution: After 20k-30k Packets a Hardfault occures -> not stable currently
2017-04-06 Embedded software: increased stability, started implementation of khSerial khSerial: RF-received telegrams get forwarded, vice-versa isn't possible yet
    [kHome-Gateway.c, khRF.c, khSerial.c]
2017-04-07 Hardware design files (schematic, board print, BOM) of temperatureSensor as PDF
    [temperatureSensor.PrjPcb]
2017-04-08 embedded software: fixed a bug: software did not go back to receive mode if a telegram was received, that didn't need an answer
    [khRF.c, khTelegram.c]
2017-04-08 first version of MQTT gateway daemon, unstable with rudimentary functionality
    [khTelegram.c, khTelegram.h, log.c, main.c, mqtt.c, mqtt.h, serial.c]
2017-04-14 The device's own address wasn't handled there properly
2017-04-20 Modified RTOS and project template for the temperatureSensor Hardware Version 1 hardware
    [m3_Hwi_asm.obj, m3_Hwi_asm_switch.obj, m3_IntrinsicsSupport_asm.obj, m3_TaskSupport_asm.obj, release.cfg, rom_sysbios.obj]
2017-04-22 Bugfix: Register addresses greater than 15 were not saved properly in device files
2017-04-22 Rudimentary firmware for temperature sensor
2017-04-22 temperature sensor device file that was used in the previous firmware
2017-04-29 Adjusted pin/ GPIO mapping for temperatureSensor
2017-04-29 Added functionality for programming mode (leads to lower power consumption)
2017-04-30 First, final revision of firmware for temperatureSensor (battery measurement, programming mode)
2017-09-16 Simple software for demonstration
    [m3_Hwi_asm.obj, m3_Hwi_asm_switch.obj, m3_IntrinsicsSupport_asm.obj, m3_TaskSupport_asm.obj, release.cfg, rom_sysbios.obj]
